poko56/PCB_33KV/PCB/BOM_PCB_33KV_2026-04-17.csv

ID | Name | Designator | Footprint | Quantity | Manufacturer Part | Manufacturer | Supplier | Supplier Part | Price
1 | + 1uf - | C9 | R_AXIAL-0.3 | 1
2 | Zener diode 3.3V | D1 | SOD-123_L2.8-W1.8-LS3.7-RD | 1 | 1N4007W | BLUE ROCKET | LCSC | C328592 | 0.01
3 | 1N4148PF | D2,D3 | DO-35_BD1.9-L3.9-P7.90-D0.5-FD | 2 | 1N4148PF | ST(先科) | LCSC | C2992430 | 0.008
4 | 5x20 BLX-Atype Fuse holder XC-7 | F1 | FUSE-TH_L22.6-W9.0 | 1 | 5x20 BLX-A型 保险丝支架 XC-7 | xcfuse(旭程) | LCSC | C3131 | 0.078
5 | Header-Female-2.54_1x13 | P1 | HDR-TH_13P-P2.54-V-F | 1 | 2.54-1*13P母 | BOOMELE(博穆精密) | LCSC | C52709 | 0.082
6 | Header-Female-2.54_1x2 | P2 | HDR-TH_2P-P2.54-V-F | 1 | 2.54-1*2P母 | BOOMELE(博穆精密) | LCSC | C49661 | 0.061
7 | 1k | R1 | R_AXIAL-0.3 | 1
8 | 10k | R6,R11 | R_AXIAL-0.3 | 2
9 | R_1%_10K | R7,R14 | R_AXIAL-0.3 | 2
10 | 100k | R10 | R_AXIAL-0.3 | 1
11 | 390 | R15 | R_AXIAL-0.3 | 1
12 | 240 | R16 | R_AXIAL-0.3 | 1
13 | 3P | U1 | KF301-5.0-3P_1 | 1 | KF301-5.0-3P | KEFA(科发) | LCSC | C474882 | 0.127
14 | 2P | U4 | CONN-TH_P5.00_KF301-5.0-2P | 1 | KF301-5.0-2P | KEFA(科发) | LCSC | C474881 | 0.092
15 | ESP-32-C3-SUPERMINI | U7 | ESP32-C3-SUPERMINI-PCB | 1
16 | LM317T | U8 | TO-220AB-3_L10.4-W4.6-P2.54-T | 1 | LM317T | ST(意法半导体) | LCSC | C361026 | 0.386
17 | TL072CP | U5 | PIT_DIP-8 | 1 | TL072CP | TI | LCSC | C7236 | 0.378
