poko56/PCB_33KV/PCB/Schematic_PCB_33KV_2026-04-17.pdf

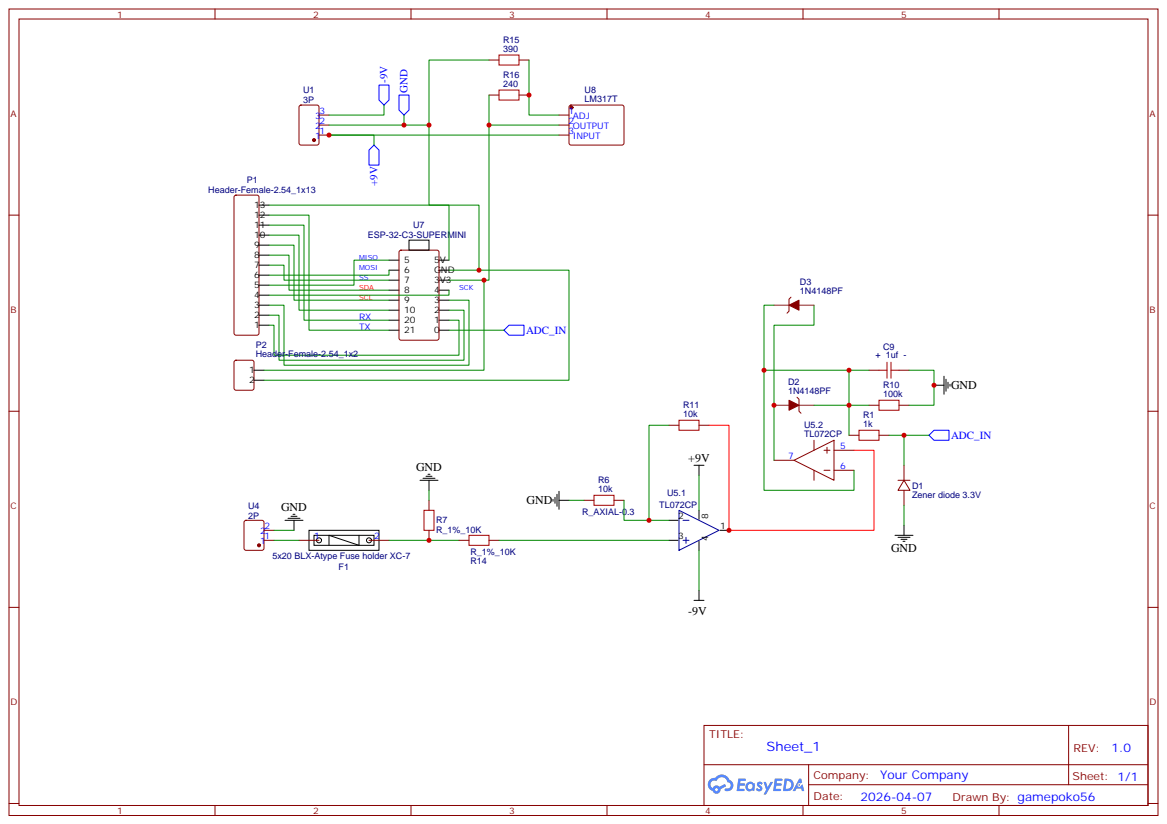
[picture p4: page 1]
