poko56/PCB_33KV/PCB/PCB_PCB_PCB_33KV_2026-04-18.pdf

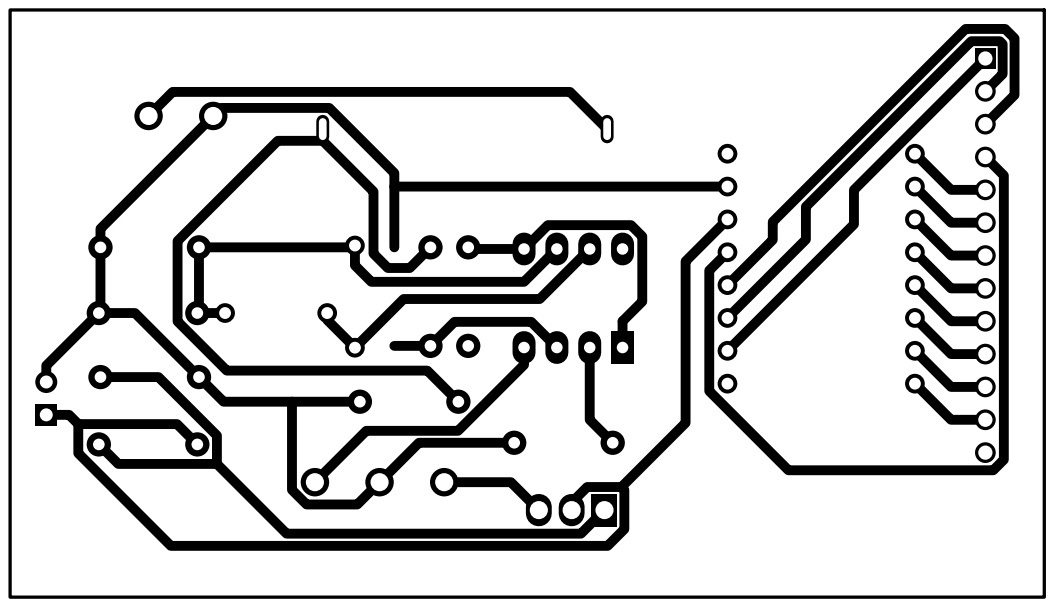
[picture p5: page 1]
