poko56/PCB_33KV/PCB/PCB_PCB_PCB_33KV_2026-04-17.pdf

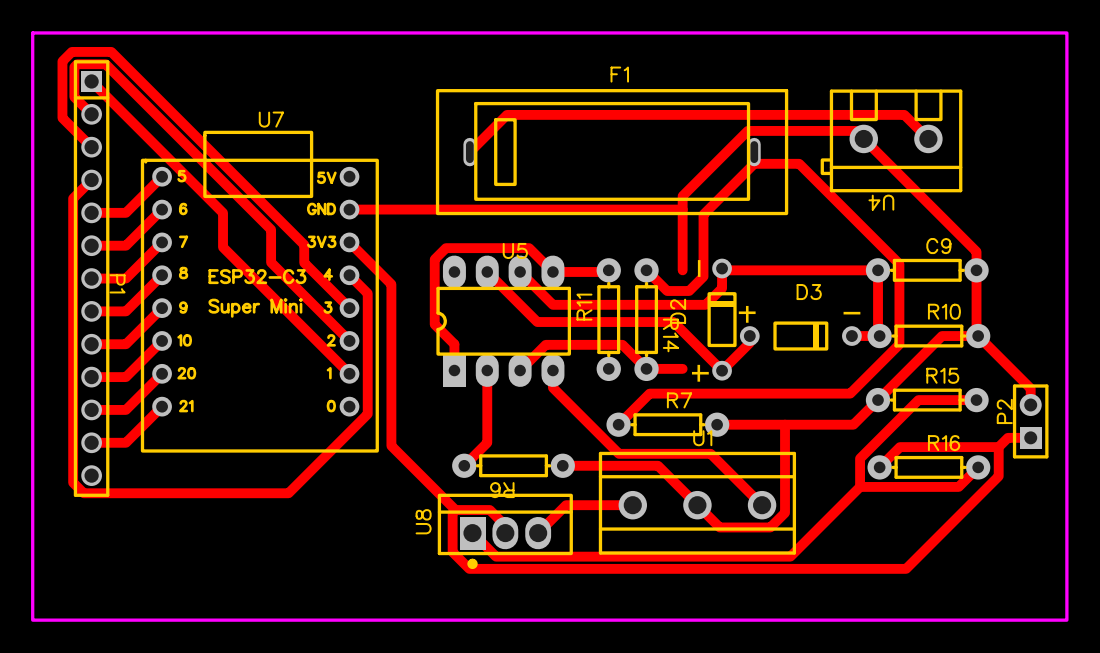
[picture p6: page 1]
