poko56/PCB_33KV/(list of files, drawings)

Other design files:
EasyEDA/SCH_PCB_33KV_2026-04-21.json
PCB/PCB_PCB_PCB_33KV-copy_2026-04-17.json
PCB/PCB_PCB_PCB_33KV_2026-04-17.json
PCB/SCH_PCB_33KV_2026-04-17.json
