poko56/PCB_33KV/(commit log)

2026-04-17 Revise README for 33kV Leakage Current Monitor
    Updated README to include detailed project information and features.
2026-04-17 Revise README for clarity and detail improvements
    Updated the README to improve clarity and accuracy of hardware and software descriptions, including adjustments to the calibration guide and feature explanations.
2026-04-17 Revise README for clarity and detail enhancement
    Updated project description, added hardware and software details, and improved calibration instructions.
